ckemere/LaserDriver/LaserHAT/LaserDriver.kicad_pcb

## KiCad design LaserHAT/LaserDriver.kicad_pcb (2026-05-15)

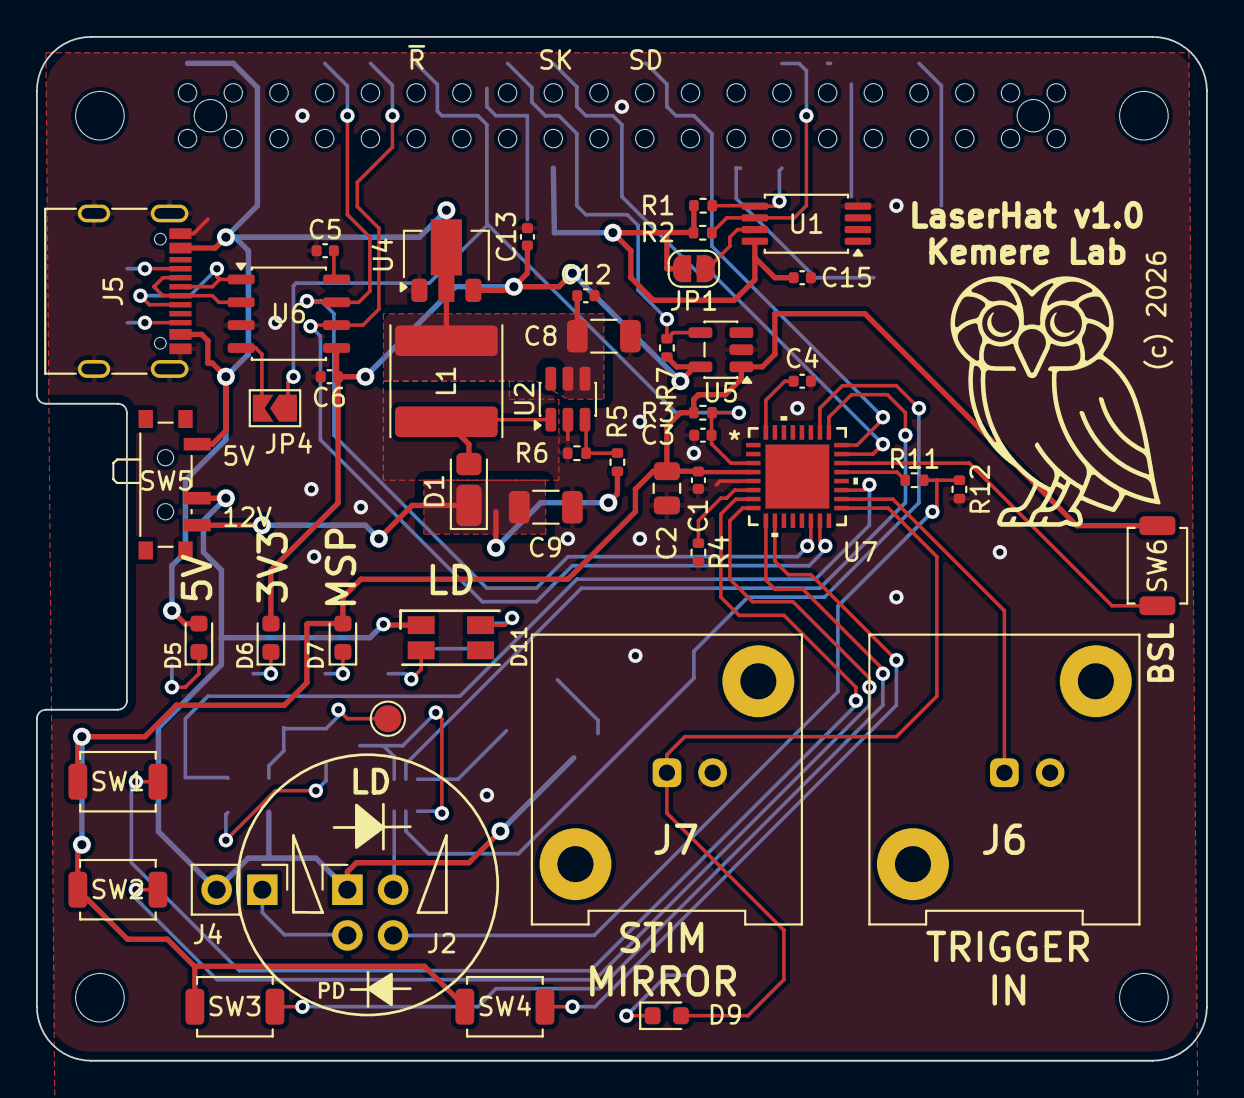
[picture p1: board LaserDriver.kicad_pcb from above]

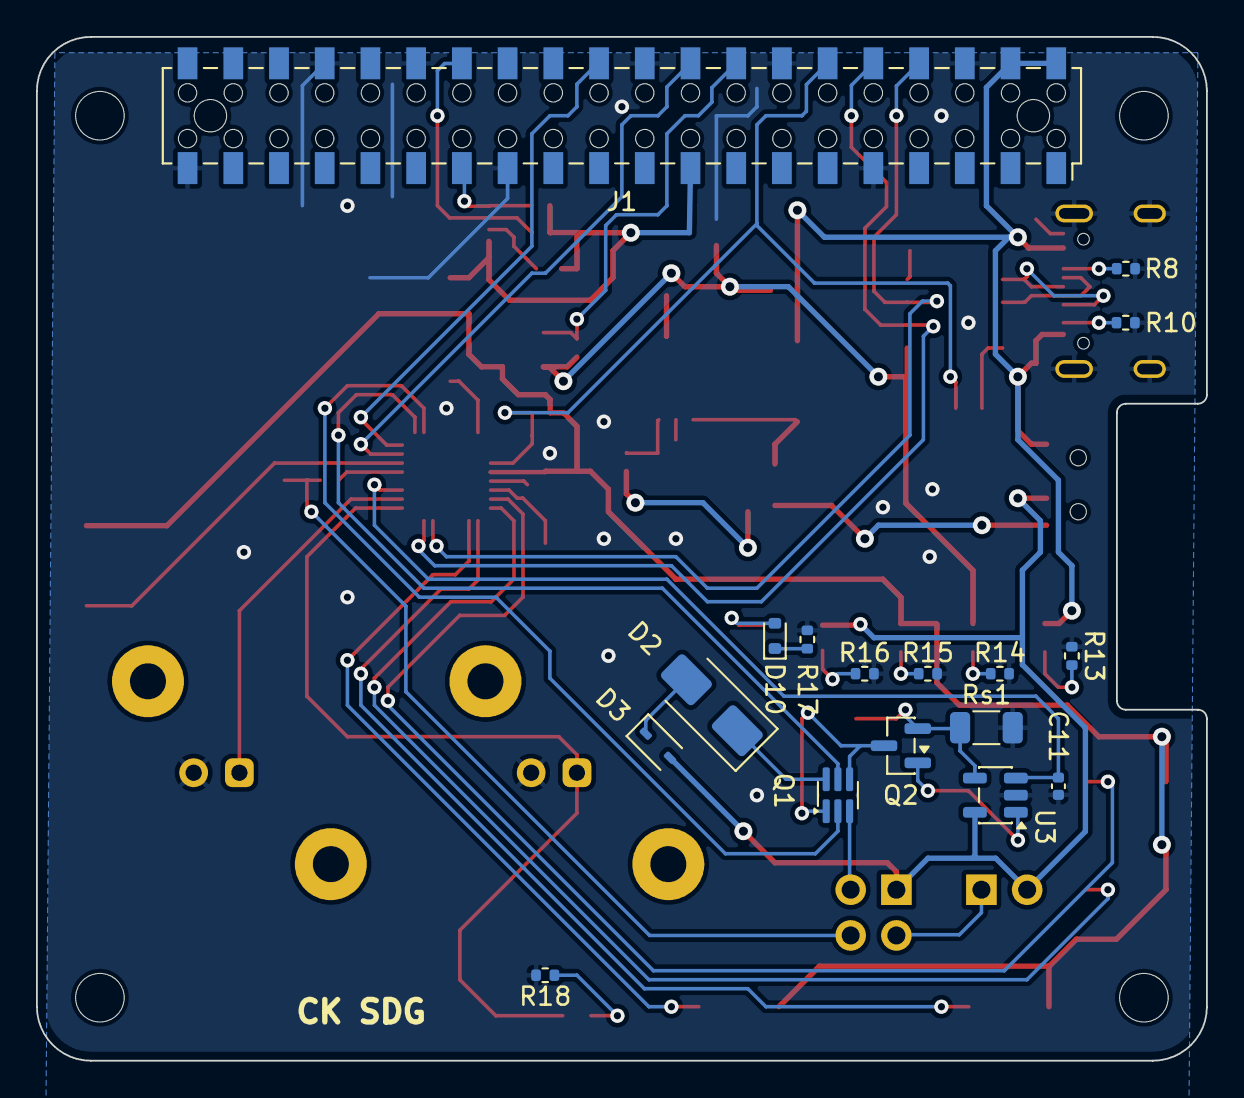
[picture p2: board LaserDriver.kicad_pcb from below]

Board: 2 copper layers, 65.0 x 56.9 mm, 68 parts (17 on the bottom side), 52 nets.

Parts:
C1, C5, C6, C12, C15: 100nF; C_0402_1005Metric
C2: 10uF; C_0805_2012Metric
C3, C11: 10nF; C_0402_1005Metric
C4: 0.47uF; C_0402_1005Metric
C8, C9: 22µF 16V; C_1206_3216Metric
C13: 1uF Ceramic; C_0402_1005Metric
D1: SS14; D_SOD-123F
D2: Zener 4.7V, 1.5W; D_SMA
D3: 1N4148W; D_SOD-323F
D5: 5V; D_0603_1608Metric
D6: 3v3; D_0603_1608Metric
D7: MSPM0; D_0603_1608Metric
D9: STIM; D_0603_1608Metric
D10: D_Zener 6.2V; D_SOD-523
D11: LED_ABGR; LED_RGB_1210
J1: GPIO; Samtec_HLE-120-02-xxx-DV-BE-LC_2x20_P2.54mm_Horizontal
J2: Conn_02x02_Counter_Clockwise; PinHeader_2x02_P2.54mm_Vertical
J4: Jumper for 4-terminal diode configuration; PinHeader_1x02_P2.54mm_Vertical
J5: USB_C_Receptacle_USB2.0_16P; USB_C_Receptacle_G-Switch_GT-USB-7010ASV
J6, J7: Conn_Coaxial; BNC_Amphenol_031-5539_Vertical
JP1: ID_WP; SolderJumper-2_P1.3mm_Open_RoundedPad1.0x1.5mm
JP4: ID_WP; SolderJumper-2_P1.3mm_Open_TrianglePad1.0x1.5mm
L1: 22uH; L_APV_ANR6045
MH1, MH2, MH3, MH4: MountingHole_2.7mm_M2.5
Q1: SI3134KDWA-TP; SOT-363_SC-70-6
Q2: DMN2056U; SOT-23
R1, R2: 3.9k; R_0402_1005Metric
R3: 47k 1%; R_0402_1005Metric
R4: 100k 0.1%; R_0402_1005Metric
R5: 187k 1%; R_0402_1005Metric
R6, R7: 10k; R_0402_1005Metric
R8, R10: 5.1k; R_0402_1005Metric
R11: 1k 0.1%; R_0402_1005Metric
R12: 4.7k; R_0402_1005Metric
R13, R17: 1k 1%; R_0402_1005Metric
R14, R15: 200; R_0402_1005Metric
R16, R18: 470; R_0402_1005Metric
Rs1: 10Ω 1%; R_1206_3216Metric
SW1, SW2, SW3, SW4: B; SW_SPST_TS-1088-xR020
SW5: SW_SPDT; SW_SPDT_PCM12
SW6: BSL; SW_SPST_TS-1088-xR020
TP1: TestPoint; TestPoint_Pad_D1.5mm
U1: CAT24C32; TSSOP-8_4.4x3mm_P0.65mm
U2: MT3608; SOT-23-6
U3: TLV2371DBV; SOT-23-5
U4: MCP1700x-330xxMB; SOT-89-3
U5: AP2171W; SOT-23-5
U6: CH340N; JEITA_SOIC-8_3.9x4.9mm_P1.27mm
U7: MSPM0G3507SRHBR; VQFN32_RHB_TEX

Connections:
+3V3: C6.1, C13.1, D6.2 (A), R7.1, U4.3 (VO), U5.5 (IN), U6.5 (VCC)
+5V: C8.1, C12.1, D5.2 (A), J1.2, J1.4, J5.A4 (VBUS), J5.A9 (VBUS), J5.B4 (VBUS), J5.B9 (VBUS), L1.1, SW5.1 (A), U2.4 (EN), U2.5 (IN), U4.2 (VI)
+12V: C9.1, D1.1 (K), R5.1, SW5.3 (C)
/GPIO14/TXD0: J1.8, U6.7 (RXD), U7.14 (PA10/CLK_OUT)
/GPIO15/RXD0: J1.10, U6.6 (TXD), U7.15 (PA11)
/GPIO18/PCM.CLK: C3.1, J1.12, JP4.1 (A), R3.2, U7.3 (NRST)
/GPIO23: J1.16, R7.2, U5.4 (EN)
/GPIO24: J1.18, U7.23 (PA19/SWDIO)
/GPIO25: J1.22, U7.24 (PA20/SWCLK)
/ID_SCL: J1.28, R2.2, U1.6 (SCL)
/ID_SDA: J1.27, R1.2, U1.5 (SDA)
/Laser Driver Circuit/DIODE_ADC: R11.1, U7.21 (PA17/A1_2)
/Laser Driver Circuit/IDrive: Q2.2 (S), Rs1.1, TP1.1, U3.4 (-)
/Laser Driver Circuit/LASER_VREF: C11.1, U3.3 (+), U7.19 (PA15/A1_0/DAC_OUT)
/Laser Driver Circuit/LaserDrive: Q1.1 (S), Q1.4 (S), Q2.3 (D)
/Laser Driver Circuit/PWM_DUMMY: Q1.2 (G), U7.26 (PA22/CLK_OUT/A0_7)
/Laser Driver Circuit/PWM_LASER: Q1.5 (G), U7.25 (PA21/A1_7/VREF-)
/Laser Driver Circuit/SW: D1.2 (A), L1.2, U2.1 (SW)
/MSPM0 Controller/BUTTON1: SW1.1, U7.7 (PA3/COMP1_OUT/LFXIN)
/MSPM0 Controller/BUTTON2: SW2.1, U7.8 (PA4/LFCLK_IN/LFXOUT)
/MSPM0 Controller/BUTTON3: SW3.1, U7.9 (PA5/HFXIN/FCC_IN)
/MSPM0 Controller/BUTTON4: SW4.1, U7.10 (PA6/HFCLK_IN/HFXOUT)
/MSPM0 Controller/MSPM0_BSL_INVOKE: SW6.1, U7.22 (PA18/A1_3)
/STIM_MIRROR: D9.2 (A), J7.1 (In), U7.17 (PA13)
/STIM_TRIGGER: J6.1 (In), U7.18 (PA14/CLK_OUT/A0_12)
/USB-C UART/CH340_RTS: JP4.2 (B), U6.4 (~RTS)
GND: C1.2, C2.2, C3.2, C4.2, C5.1, C6.2, C8.2, C9.2, C11.2, C12.2, C13.2, C15.2, J1.6, J1.9, J1.14, J1.20, J1.25, J1.30, J1.34, J1.39, J5.A1 (GND), J5.A12 (GND), J5.B1 (GND), J5.B12 (GND), J5.S1 (SHIELD), J6.2 (Ext), J7.2 (Ext), R4.2, R6.2, R8.2, R10.2, R12.2, R13.2, R14.2, R15.2, R16.2, R17.2, R18.2, Rs1.2, U1.4 (GND), U2.2 (GND), U3.2 (V-), U4.1 (GND), U5.2 (GND), U6.3 (GND), U7.5 (VSS)
LASER_V: D3.2 (A), D11.1 (A), J2.1 (LD_Anode), J4.2, SW5.2 (B), U3.5 (V+)
MSPM0_3V3: C1.1, C2.1, D7.2 (A), R3.1, SW1.2, SW2.2, SW3.2, SW4.2, SW6.2, U5.1 (OUT), U7.4 (VDD)
unnamed: D2.2 (A), D3.1 (K)
unnamed: D2.1 (K), Q1.6 (D)
unnamed: D5.1 (K), R13.1
unnamed: D6.1 (K), R14.1
unnamed: D7.1 (K), R15.1
unnamed: D9.1 (K), R18.1
unnamed: D10.2 (A), D11.4 (RK)
unnamed: D10.1 (K), R17.1
unnamed: D11.2 (BK), R16.1
unnamed: J2.2 (LD_Cathode), Q1.3 (D)
unnamed: J2.4 (PD_Anode), R11.2, R12.1
unnamed: J2.3 (PD_Cathode), J4.1
unnamed: J5.A5 (CC1), R8.1
unnamed: J5.B5 (CC2), R10.1
unnamed: JP1.1 (A), U1.7 (WP)
unnamed: Q2.1 (G), U3.1
unnamed: R5.2, R6.1, U2.3 (FB)
unnamed: J5.A6 (D+), J5.B6 (D+), U6.1 (UD+)
unnamed: J5.A7 (D-), J5.B7 (D-), U6.2 (UD-)
unnamed: C5.2, U6.8 (V3)
ROSC: R4.1, U7.6 (PA2/ROSC)
RPi +3V3: C15.1, J1.1, J1.17, JP1.2 (B), R1.1, R2.1, U1.8 (VCC)
VCORE: C4.1, U7.32 (VCORE)
