ckemere/LaserDriver/PCB/laser_driver.kicad_pcb

## KiCad design PCB/laser_driver.kicad_pcb (2026-04-27)

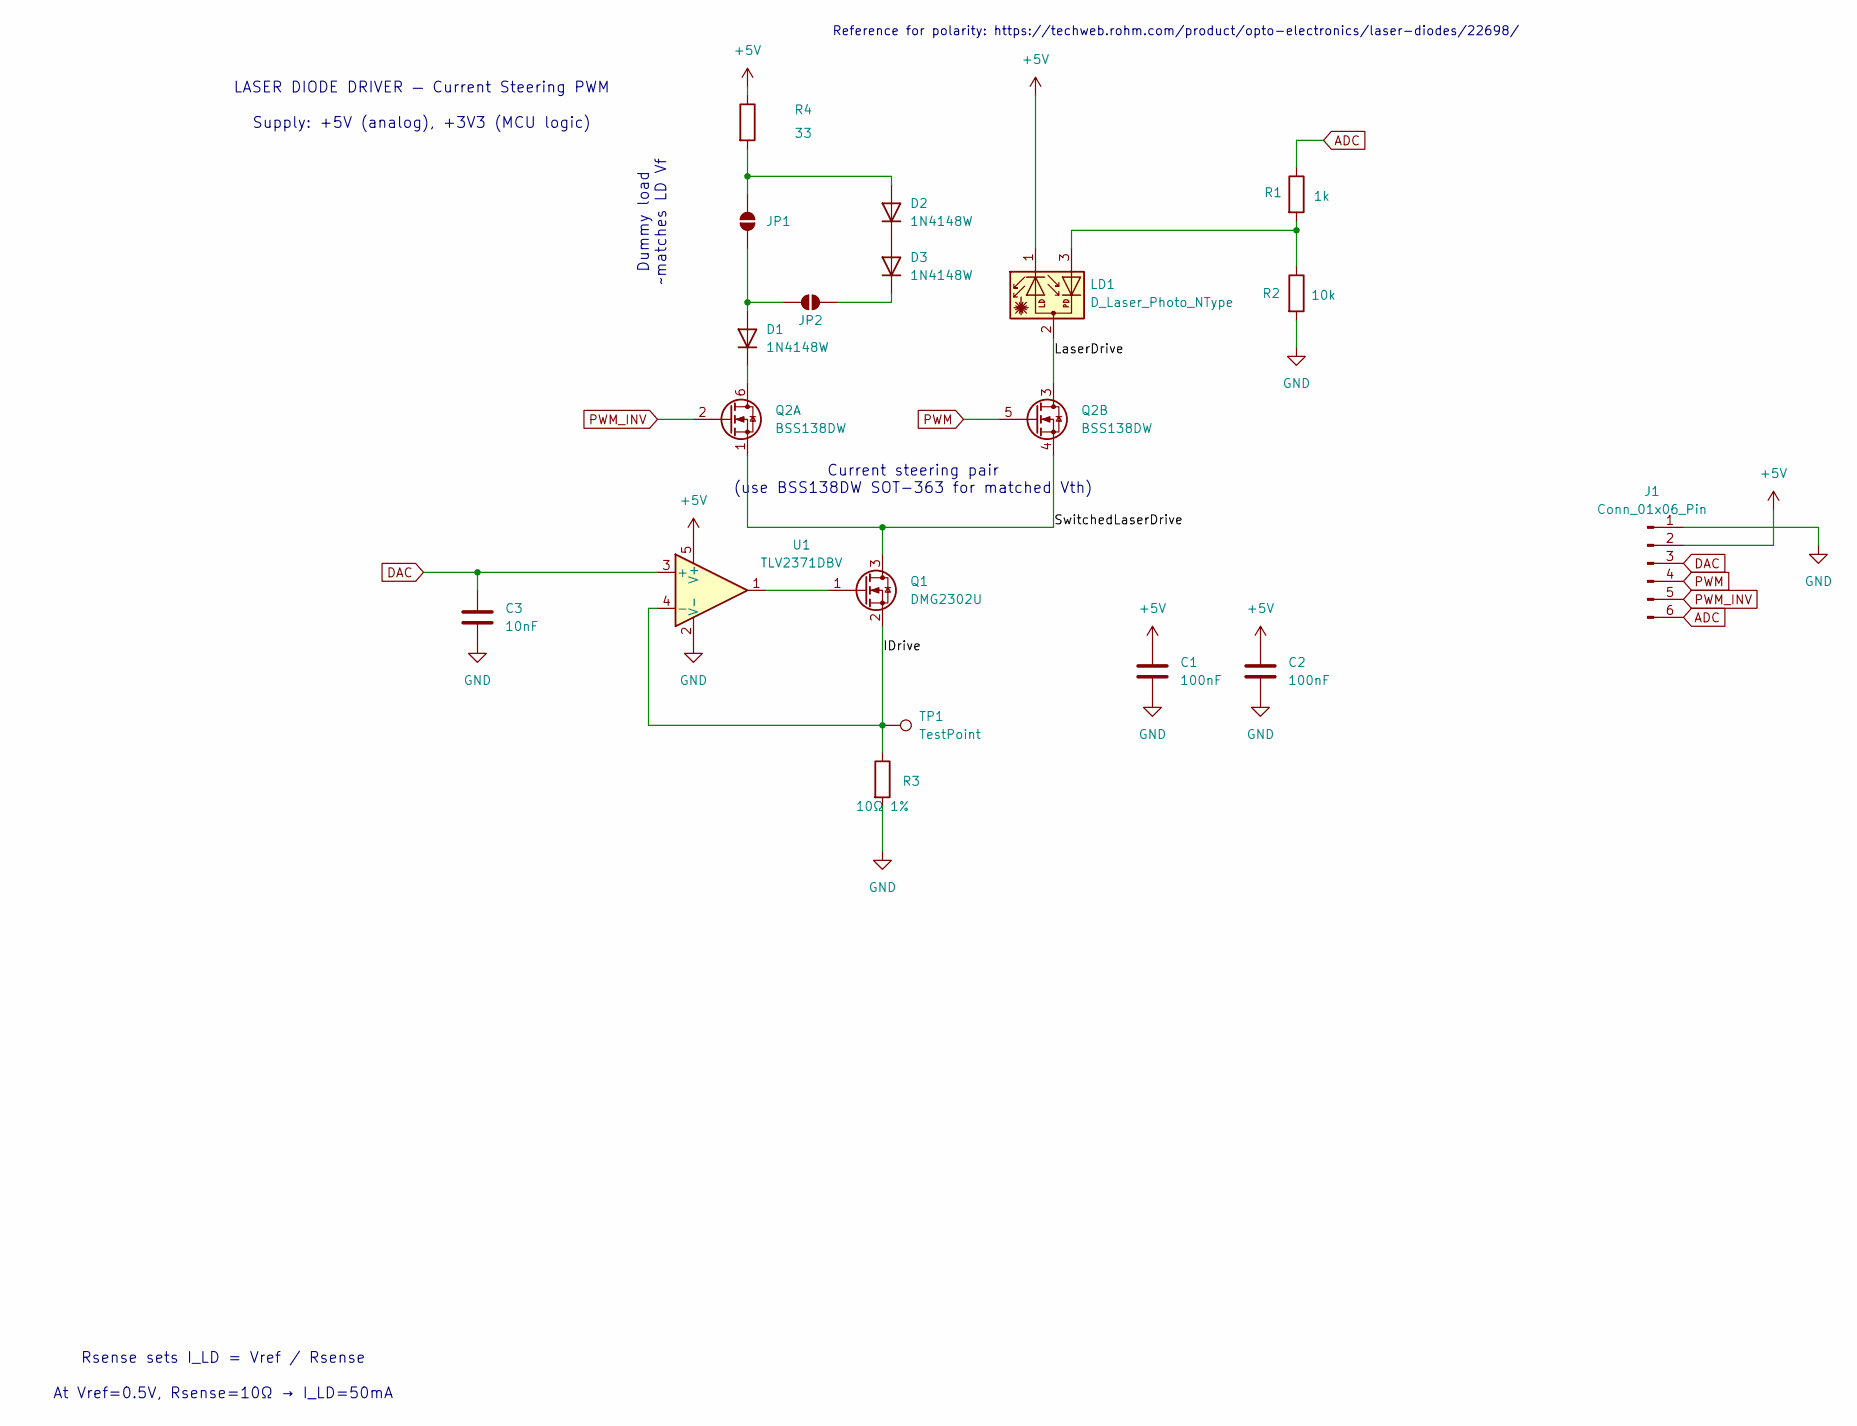
[picture p4: schematic laser_driver.kicad_sch, Laser Diode Driver with Current Steering PWM]

Parts:
C1, C2: 100nF; C_0402_1005Metric
C3: 10nF; C_0402_1005Metric
D1, D2, D3: 1N4148W; D_SOD-123
J1: Conn_01x06_Pin; PinHeader_1x06_P2.54mm_Vertical
JP1, JP2: SolderJumper-2_P1.3mm_Open_TrianglePad1.0x1.5mm
LD1: D_Laser_Photo_NType; PinHeader_1x03_P2.54mm_Vertical
Q1: DMG2302U; SOT-23
Q2: BSS138DW; SOT-363_SC-70-6
R1: 1k; R_0402_1005Metric
R2: 10k; R_0402_1005Metric
R3: 10Ω 1%; R_0402_1005Metric
R4: 33; R_0402_1005Metric
TP1: TestPoint; PinHeader_1x01_P2.54mm_Vertical
U1: TLV2371DBV; SOT-23-5

Connections:
+5V: C1.1, C2.1, J1.2, LD1.1, R4.1, U1.5 (V+)
/IDrive: Q1.2 (S), R3.1, TP1.1, U1.4 (-)
/LaserDrive: LD1.2, Q2.3 (D)
/SwitchedLaserDrive: Q1.3 (D), Q2.1 (S), Q2.4 (S)
ADC: J1.6, R1.1
DAC: C3.1, J1.3, U1.3 (+)
GND: C1.2, C2.2, C3.2, J1.1, R2.2, R3.2, U1.2 (V-)
unnamed: D1.2 (A), JP1.2 (B), JP2.2 (B)
unnamed: D1.1 (K), Q2.6 (D)
unnamed: D2.2 (A), JP1.1 (A), R4.2
unnamed: D2.1 (K), D3.2 (A)
unnamed: D3.1 (K), JP2.1 (A)
unnamed: LD1.3, R1.2, R2.1
unnamed: Q1.1 (G), U1.1
PWM: J1.4, Q2.5 (G)
PWM_INV: J1.5, Q2.2 (G)

Notes on the sheet:
Supply: +5V (analog), +3V3 (MCU logic)
Current steering pair (use BSS138DW SOT-363 for matched Vth)
Dummy load ~matches LD Vf
Rsense sets I_LD = Vref / Rsense
LASER DIODE DRIVER — Current Steering PWM
Reference for polarity: https://techweb.rohm.com/product/opto-electronics/laser-diodes/22698/
At Vref=0.5V, Rsense=10Ω → I_LD=50mA

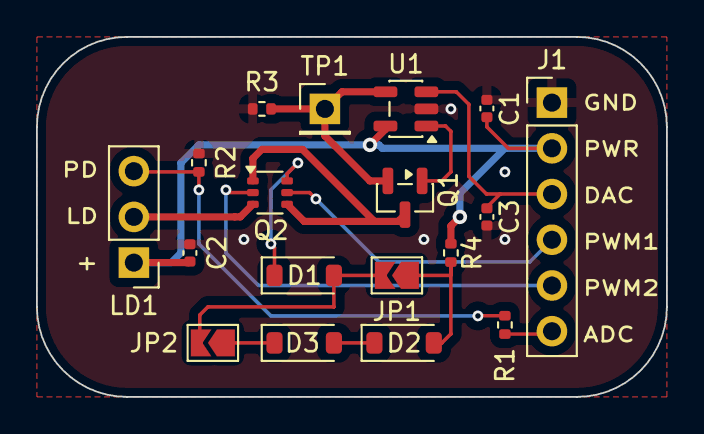
[picture p5: board laser_driver.kicad_pcb from above]

Board: 2 copper layers, 35.0 x 20.0 mm, 18 parts (0 on the bottom side), 16 nets.
