ckemere/LaserDriver/(commit log)

2026-04-27 Initial Commit of PCB
    [laser_driver.kicad_pcb, laser_driver.kicad_sch]
2026-04-27 Add complementary PWM modulation to laser driver firmware
    Adds a TIMA0-based complementary PWM output pair on PA12/PA13 (J4
    header pins) to drive the H-bridge gates Q2a/Q2b in the current
    steering topology described in PCB/DESIGN_NOTES.md.
    Configuration:
    - TIMA0, CC0 channel with native CCP0/CCP0N complementary outputs
    - Clock: BUSCLK = 32 MHz, prescale = 1
    - Period: 3200 counts → 100 µs (10 kHz)
    - Duty cycle: ccValue = 1600 → 50% initially
    - No deadband: both outputs flip on the same compare event, ensuring
    the current source Q1 always has a path to ground through Q2a or Q2b
    - Shadow load enabled for clean duty-cycle updates at timer zero event
    laser_driver.c: start PWM counter aft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
    [laser_driver.c]
2026-04-27 Add PA0 GPIO blink at ~1 Hz after laser diode enable
    Configures PA0 as a push-pull output via SysConfig (GPIO_BLINK group)
    and replaces the WFI idle loop with a busy-wait toggle loop that fires
    every 500 ms (~1 Hz) using the 32 MHz default MCLK.
    [laser_driver.c]
2026-04-27 Add complementary PWM modulation at 10% laser duty cycle
    Configure TIMA0 in edge-aligned PWM mode at 10 kHz using the native
    CCP0/CCP0N complementary pair (PA8/PA22, no deadband generator) to
    steer current between the laser path (Q2a) and dummy path (Q2b).
    Both outputs flip on the same compare event giving zero guard band.
    10% duty cycle: ccValue=2880 of 3200 counts, laser ON 10% of period.
    [laser_driver.c]
2026-04-28 Ensure safe boot: DAC zero, dummy branch always on, laser branch off
    Set DAC12 output voltage to 0 V so the current setpoint is zero on
    startup. Set PWM ccValue to 3199 (= timerCount) so CCP0 (dummy path)
    is HIGH for ~100% of each cycle and CCP0N (laser path) is HIGH for
    only ~31 ns per 100 µs period; with DAC = 0 V the laser diode is
    never driven even during that brief window.
2026-04-28 Add trapezoidal laser pulse ramp at 100 kHz PWM
    Raises PWM frequency from 10 kHz to 100 kHz (period=320 counts at 32 MHz
    BUSCLK) giving 320-step duty-cycle resolution.
    Implements a repeating trapezoidal intensity profile driven by the TIMA0
    zero-event ISR:
    - Rise: 0 % -> 100 % over 2 s (625 ticks/step × 320 steps)
    - Hold high: 100 % for 1 s
    - Fall: 100 % -> 0 % over 2 s
    - Hold low: 0 % for 1 s
    DAC setpoint is fixed at 100 (≈ 61 mV on the 2.5 V reference) and set
    once at boot before pulses start. A pulse_active flag gates the state
    machine; currently auto-set in main so the ramp begins at power-on.
    Setting it from a button ISR instead will be straightforward to add.
    Co-Authored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
    [laser_driver.c]
2026-04-28 Fix flash at end of ramp-down; drive output unconditionally in every state
    Root cause: STATE_HOLD_HIGH never called set_laser_step, leaving the PWM
    shadow register with ccValue=0 (laser 100%) from the last RAMP_UP tick.
    That stale value persisted into the first ~625 ticks of STATE_RAMP_DOWN,
    producing a bright flash before the first ramp step could override it.
    Fix: move set_laser_step to the bottom of every state case, after updating
    ramp_step, so the shadow register is always driven to the correct value on
    every tick regardless of whether a threshold fired or a transition occurred.
    Also removes the now-redundant ramp_step=RAMP_STEPS assignment in HOLD_HIGH
    since HOLD_HIGH drives set_laser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
    [laser_driver.c]
2026-04-28 Implement safe laser-off via IOMUX switching between GPIO and PWM
    Bridge pins PA8/PA22 now boot as GPIO (dummy HIGH, laser LOW) via
    SysConfig GPIO instances. laser_pwm_control.c switches them to
    TIMA0_CCP0/CCP0_CMPL at runtime when PWM is active, and back to
    GPIO-safe-state when the laser should be off — eliminating the
    ccValue=320 ambiguity that could produce full laser power.
2026-04-28 Remove PWM from SysConfig; configure TIMA0 entirely in software
    SysConfig PWM module was defaulting to PA0 as its CCP0 output pin,
    modulating an unrelated LED. Remove the PWM module from syscfg so
    SysConfig never touches TIMA0 pins. Add laser_pwm_init() which
    replicates the same timer configuration (BUSCLK/1, 100 kHz
    edge-aligned PWM, CC0 shadow-on-zero) using driverlib calls directly.
    Update laser_driver.c to call laser_pwm_init() and reference TIMA0
    and TIMA0_INT_IRQn directly instead of the now-gone generated macros.
2026-04-29 Switch to UP-mode PWM, fix pin naming, separate tick timer
    Three changes:
    - Pin naming: PA8 is the laser branch (CCP0 direct), PA22 is the
    dummy branch (CCP0_CMPL). Rename SysConfig GPIO instances and all
    code references accordingly.
    - UP-mode PWM: switch TIMA0 to DL_TIMER_PWM_MODE_EDGE_ALIGN_UP with
    INIT_VAL_HIGH so CC0 value maps directly to laser duty
    (0 = off, 320 = 100%). Removes the inverted subtraction from
    set_laser_step().
    - Separate tick timer: TIMG0 generates the 100 kHz state-machine
    tick interrupt; TIMA0 runs pure PWM with no interrupt, making the
    role of each timer unambiguous.
    [laser_driver.c, laser_pwm_control.c]
2026-04-29 Fixed Claude errors, including correcting laser off GPIO settings and fixing initial GPIO state. Updated instructions.
    [laser_driver.c, laser_pwm_control.c]
2026-04-29 Refactor state machine into get_next_state/set_output functions
    State is now a LaserState struct (phase + ramp_step + tick_count) so
    both transition logic and hardware output are fully determined by the
    struct alone. Main loop reduces to three lines. Document the philosophy
    in CLAUDE.md.
2026-04-29 Add button trigger on PB21 with debounced release detection
    PB21 is configured as active-low input with internal pull-up via SysConfig.
    The state machine grows a ButtonPhase sub-state and an OverallPhase that
    separates WAITING_FOR_TRIGGER from TRIGGERED. Pressing then releasing the
    button fires one trapezoidal laser cycle; further presses are ignored until
    the cycle completes. Button is polled at 100 kHz; 10 ms debounce applied
    to both press and release edges.
2026-04-30 Add Raspberry Pi HAT laser driver KiCad project (LaserHAT/)
    Four-sheet hierarchical schematic based on the Rpi-pcb template UUID:
    - Root sheet: Pi 2×20 GPIO connector, DMG2305UX P-MOSFET MSPM0 power
    switch (Pi GPIO17), BNC trigger input, 5-pin SWD header, AT24C256C
    HAT EEPROM with 4.7k I2C pull-ups
    - Sheet 2 (laser_driver_circuit): MT3608 boost converter (5V→12V,
    R_FB1=187k/R_FB2=10k → 11.82V), full TLV2371/Si1902DL/Q1 current-
    steering driver with fail-safe gate pull resistors
    - Sheet 3 (mspm0_controller): MSPM0G3507RGZR QFN-64 with decoupling;
    PA8=PWM_LASER, PA22=PWM_DUMMY, PA12=DAC/VREF, PB21=TRIGGER
    - Sheet 4 (usb_uart): CH340N USB-C UART bridge with SB1/SB2 solder
    bridg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
    [LaserDriver.kicad_pcb, LaserDriver.kicad_sch, laser_driver_circuit.kicad_sch, mspm0_controller.kicad_sch, usb_uart.kicad_sch]
2026-04-30 Regenerate schematics via kiutils; add generate_schematics.py
    Previous hand-written schematics failed to open in eeschema due to
    quoted UUIDs and unrecognised generator_version field. Replace with
    a kiutils-based Python generator that produces correctly-formatted
    KiCad 9 S-expressions.
    Each sheet now has:
    - Unquoted UUIDs and proper PageSettings object (eeschema-compatible)
    - HierarchicalLabel port declarations matching parent sheet pins
    - LocalLabel net labels placed at exact pin connection points so KiCad
    can build the netlist without manual wire routing
    - NoConnect markers on unused pins (SBU1/SBU2, DTR, MT3608 NC pin)
    - SymbolInstance entries for BOM/netlist annotation
    Add requireme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
    [LaserDriver.kicad_sch, laser_driver_circuit.kicad_sch, mspm0_controller.kicad_sch, usb_uart.kicad_sch]
2026-04-30 Fix pin orientation error: set angle=0 on lib symbol pins with angle=None
    KiCad eeschema requires a numeric angle in every pin (at X Y angle) clause.
    Lib symbols copied from the original hand-written schematics had angle=None
    on connector pins, which kiutils serialised as (at X Y) — two numbers
    instead of three — causing the 'need a number for pin orientation' parse
    error.
    Add _fix_lib_sym_angles() called from copy_lib_syms() to default any
    None angle to 0 before the symbol is added to the output schematic.
    [LaserDriver.kicad_sch, laser_driver_circuit.kicad_sch, mspm0_controller.kicad_sch, usb_uart.kicad_sch]
2026-04-30 Implement schematic design rules; add CLAUDE.md
    - Rule 1: hide pin names/numbers on passive parts (R, C, L)
    - Rule 2: add ≥5mm wire stub before every net label
    - Rule 3: preserve hand-edited laser_driver.kicad_sch by loading from PCB/ original
    - Rule 4: generous component spacing across multiple sheets
    - Add CLAUDE.md documenting all rules, setup, signal naming, and kiutils conventions
    [LaserDriver.kicad_sch, laser_driver_circuit.kicad_sch, mspm0_controller.kicad_sch, usb_uart.kicad_sch]
2026-04-30 Fix three schematic generation bugs
    - Symbol unit names: set entryName on manually-created Symbol units so
    they serialize as "+LASER_V_0_1" not "None_0_1" (KiCad load error)
    - Passive pin hiding: set pinNames=True alongside pinNamesHide=True so
    the (pin_names hide) token is actually emitted for Device:C and Device:L
    - Property visibility: hide Footprint/Datasheet/Description on all
    schematic symbol instances; only Reference and Value remain shown
    [LaserDriver.kicad_sch, laser_driver_circuit.kicad_sch, mspm0_controller.kicad_sch, usb_uart.kicad_sch]
2026-04-30 Fix PCB file: remove semicolon comments, drop invalid pintype tokens
    KiCad S-expression parser does not support any comment syntax.
    Semicolon comments on lines 93+ caused the 'Expecting (' parse error.
    Also removed (pintype "passive") from pad entries — that token belongs
    in schematics, not PCB files.
    [LaserDriver.kicad_pcb]
2026-04-30 Document PCB file rules in CLAUDE.md
2026-05-01 Add RPi 40-pin GPIO header to root schematic with full pin connections
    - place_pi_header() places Conn_02x20_Odd_Even at (40, 230) with:
    - Pins 1,17: +3V3 power symbols
    - Pins 2,4: VCC_5V_IN net labels (boost converter input)
    - Pins 6,9,14,20,25,30,34,39: GND power symbols
    - Pin 8/10: UART_TX/UART_RX (GPIO14/15)
    - Pin 11: Pi_GPIO17 (MCU power enable → R_GATE)
    - Pins 27/28: ID_SDA/ID_SCL (HAT EEPROM, per HAT spec)
    - Pin 37: TRIGGER (GPIO26 → BNC/MSPM0)
    - All other pins: no-connect markers
    - Fix TRIGGER_SIG → TRIGGER to match MSPM0 sub-sheet port name
    - Fix power:3V3 → power:+3V3 bug (lstrip("+") was wrong)
    [LaserDriver.kicad_sch, mspm0_controller.kicad_sch]
2026-05-01 Preserve GPIO header UUID by loading from original schematic
    The PCB footprint for J1 (40-pin GPIO header) has
    (path "/212bfd25-0010-0000-0000-000000000001")
    which must match the schematic symbol UUID. Regenerating the symbol
    with a random UUID silently orphans the footprint.
    Fix: build_root() now loads PCB/laserhat_root_orig.kicad_sch (extracted
    from the initial commit) and borrows the pristine Conn_02x20_Odd_Even
    lib symbol + J1 instance verbatim. Only net labels/power symbols/
    no-connects are added; the symbol itself (UUID, pin UUIDs, position,
    lib symbol definition) is untouched.
    Also add hide_extra_properties() call at end of build_root() and
    document the UUID invariant in CLAUDE.md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
    [LaserDriver.kicad_sch, laserhat_root_orig.kicad_sch]
2026-05-01 Added hat template files to this branch
    [PiHatTemplate.kicad_pcb, PiHatTemplate.kicad_sch]
2026-05-02 Rebase schematic and PCB from PiHatTemplate
    Schematic (LaserDriver.kicad_sch): template taken as base verbatim,
    preserving all GPIO connector symbols, pin labels, decoupling caps,
    ID EEPROM notes, and solder jumpers exactly as drawn. Paper changed
    A4→A3; title block updated. Three sub-sheet boxes (Laser Driver,
    MSPM0, USB-C UART) appended at x=230 to avoid overlap with the
    template's GPIO content.
    PCB (LaserDriver.kicad_pcb): replaced with PiHatTemplate PCB, which
    uses the correct PinSocket_2x20 on B.Cu (female, mates with Pi header)
    and includes proper board-outline notches, stackup, and mounting holes.
    Updated sheetfile reference to LaserDriver.kicad_sch; J1 UUID link
    (00000000-0000-000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
    [LaserDriver.kicad_pcb, LaserDriver.kicad_sch]
2026-05-02 Fix floating hierarchical_labels in child schematics
    Every hierarchical_label must be at the end of a connected wire stub.
    The generated schematics had hlabels placed at sheet-edge coordinates
    (5,20-80) and (200,20-50) with no wires, while using local labels at
    the actual pin stubs.
    fix_labels.py:
    - Removes floating hlabels from mspm0_controller and usb_uart sheets
    - Replaces each signal's local label with a hierarchical_label at the
    same wire-stub position (9 signals in MSPM0, 4 in USB-UART)
    - Adds VCC_3V3_MCU/GND hlabels in MSPM0 via short wire stubs branching
    off the existing VDD/VSS power symbol connection points
    Also commits generate_schematics.py verbatim-injection patch and mino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
    [laser_driver_circuit.kicad_sch, mspm0_controller.kicad_sch, usb_uart.kicad_sch]
2026-05-04 Add LaserHAT README with design overview and key subsystem docs
    Covers: design philosophy (Pi for timing, MCU for precision), power
    system (MT3608 boost, P-MOSFET MCU power switch), laser driver
    (current-steering PWM topology, BSS138DW pair, TLV2371 feedback),
    USB/UART dual-mode interface (SB1/SB2 solder bridges), MSPM0 pin
    assignments, and SWD debug header pinout.
2026-05-06 Updates with lots of manual work
    [LaserDriver.kicad_sch, eink.kicad_sch, laser_driver_circuit.kicad_sch, mspm0_controller.kicad_sch, usb_uart.kicad_sch]
2026-05-09 Updates to design, finalized PCB layout
    [LaserDriver.kicad_pcb, LaserDriver.kicad_sch, laser_driver_circuit.kicad_sch, mspm0_controller.kicad_sch, usb_uart.kicad_sch]
2026-05-15 Updated project for manufacturing. Should merge branch if/when we get back a working product
    [LaserDriver.kicad_pcb, LaserDriver.kicad_sch, laser_driver_circuit.kicad_sch, mspm0_controller.kicad_sch, usb_uart.kicad_sch]
2026-06-02 Added laserHat firmware rev 0.1
2026-06-03 Fix PWM laser drive to use PA21 (TIMA0_CCP0 on PINCM46)
    U7 (VQFN-32) wires PWM_LASER to PA21, not PA8. PA21 supports
    TIMA0_CCP0 via PINCM46 PF=5, so the fix is just swapping the IOMUX
    function constants in laser_pwm_control.c. Timer setup, CCP0 indices,
    and the PA22 dummy path are unchanged.
    Also: restore the bypassed RAMP_DOWN transition, fix the DAC setpoint
    comment, and call laser_pins_to_gpio_safe() explicitly at boot.
    Add LaserHAT/gpio_design.md documenting the validated Pi-and-MCU GPIO
    map for U7 along with remaining firmware/HW gaps.
    [laser_driver.c, laser_pwm_control.c, laser_pwm_control.h]
2026-06-03 Add boot blink; fix button polarity to active-high with PULL_DOWN
    Buttons are wired to +3V3 on press (verified on schematic: SW1 pin 2 ->
    MSPM0_3V3), so the prior PULL_UP + active-low read would never see a
    press. Switch syscfg to PULL_DOWN and flip the polarity check in
    get_next_state().
    Replace the TIMER_0/TIMG7 heartbeat blink (which fought set_output()
    for the STIM_MIRROR LED on PA13) with a self-contained OVERALL_BOOT
    phase: ~4 s of 5 Hz blink on PA13 at power-on, then transition to
    OVERALL_WAITING. During pulses STIM_MIRROR follows the laser-on state.
    Drop the TIMER_0 module from syscfg and its IRQ handler.
    Document the button wiring and pull-down requirement in
    LaserHAT/gpio_design.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
    [laser_driver.c]
2026-06-03 Add board.h + register-level SYSCTL and GPIO modules
    First step toward dropping the SysConfig / driverlib dependency so the
    firmware can be built with stock arm-none-eabi-gcc on the Pi.
    - board.h centralizes pin assignments (PA21 PWM_LASER, PA22 PWM_DUMMY,
    PA3 BUTTON1, PA13 STIM_MIRROR, PA15 DAC, PA10/PA11 UART, PA23 VREF+)
    so peripheral modules don't need SysConfig-generated names.
    - laser_sysctl.c/h replaces SYSCFG_DL_SYSCTL_init: BOR level 0, SYSOSC
    base 32 MHz, MFPCLK on sourced from SYSOSC.
    - laser_gpio.c/h replaces SYSCFG_DL_GPIO_init: unused-pin defaults,
    PA21/PA22 digital outputs, PA3 input with PULL_DOWN, PA13 LED output.
    Inline hot-path read/set/clear helpers for button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
    [board.h, laser_driver.c, laser_gpio.c, laser_gpio.h, laser_sysctl.c, laser_sysctl.h]
2026-06-03 Add register-level laser_timera (TIMA0 PWM) module
    laser_timera_init() replaces what laser_pwm_init() does through
    driverlib: TIMA0 reset + power-enable, BUSCLK source /1, period 320,
    edge-aligned up-counting four-CC PWM, CC0 INIT_VAL_HIGH, CCUPD at
    zero-event, CC0 output declared. Constants come straight from the
    device header (GPTIMER_* aliases that DL_TIMER_* resolved to).
    Inline laser_timera_set_duty() writes CC_01[0] directly for the
    state-machine hot path.
    Runs in parallel with the existing laser_pwm_init(); the latter still
    writes the same registers a moment later, so behavior is unchanged on
    the bench. Will collapse once the SysConfig-driven path is dropped.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
    [laser_driver.c, laser_timera.c, laser_timera.h]
2026-06-03 Add register-level laser_timerg (TIMG0 100 kHz tick) module
    laser_timerg_init() configures TIMG0 as periodic DOWN-counting timer
    at 100 kHz with the zero-event interrupt unmasked at the peripheral.
    Same register sequence the existing tick_timer_init() drives through
    driverlib, just spelled out with GPTIMER_* device-header constants.
    Inline laser_timerg_ack() reads CPU_INT.IIDX from the IRQ handler.
2026-06-03 Add register-level laser_dac (DAC0 + internal VREF) module
    laser_dac_init() brings up VREF first (buffered 2.5 V output sourced
    from LFCLK) then DAC0 (12-bit binary, VEREFP/VEREFN source, output
    amplifier on, FIFO + sample timer disabled). laser_dac_write12() is
    an inline DATA0 write; laser_dac_enable() flips the CTL0 enable bit.
    Same register sequence as SYSCFG_DL_VREF_init + SYSCFG_DL_DAC12_init,
    spelled out against VREF_*/DAC12_* device-header aliases.
    [laser_dac.c, laser_dac.h, laser_driver.c]
2026-06-03 Route hot-path GPIO/timer/IRQ through register-level modules
    laser_driver.c's runtime code (button read, STIM_MIRROR set/clear,
    TIMA0 duty update, TIMG0 + UART0 IRQ handlers) now calls the new
    register-level inlines instead of driverlib. Local set_laser_step and
    tick_timer_init helpers are gone — replaced by laser_timera_set_duty
    and laser_timerg_init/_start.
    SYSCFG_DL_init() still runs at boot as a redundant safety net
    (SysConfig and our hand-rolled modules both write the same registers
    to the same values). Removing it is the next step, but it needs a
    UART init port and a Makefile change to stop running the SysConfig
    generator — held for tomorrow.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
    [laser_driver.c]
2026-06-03 Drop SysConfig dependency: add laser_uart, retire ti_msp_dl_config
    laser_uart.c/h replicates SYSCFG_DL_UART_0_init at register level:
    reset+power, BUSCLK source /1, 8N1 no flow control, 16x oversampling,
    IBRD=208 FBRD=21 (9600 baud at 32 MHz), RX interrupt enabled. Inline
    helpers for IIDX/RX/TX.
    laser_pwm_control.c now uses board.h pin macros instead of the
    SysConfig-generated BRIDGE_LASER_* names, and its TIMA0 init function
    is gone (replaced by laser_timera_init). Header trimmed to just the
    two runtime pin-mux flips.
    laser_driver.c: dropped SYSCFG_DL_init(), the ti_msp_dl_config.h
    include, the duplicate DL_TimerG_startCounter, and laser_pwm_init.
    Boot path is now strictly the laser_*_i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
    [laser_driver.c, laser_pwm_control.c, laser_pwm_control.h, laser_uart.c, laser_uart.h]
2026-06-03 Add Makefile.gcc for arm-none-eabi-gcc Pi-native builds
    Mirrors the ticlang Makefile but targets stock arm-none-eabi-gcc using
    the SDK's gcc startup file and .lds linker script. Outputs .elf, .bin
    (BSL-friendly raw image), and .hex (OpenOCD/probe-friendly).
    Drop SDK_ROOT in via make var when vendoring the SDK to a different
    path on the Pi:
    make -f Makefile.gcc SDK_ROOT=~/mspm0_sdk all
    Untested on this box (arm-none-eabi-gcc not installed); flags are
    standard for Cortex-M0+ embedded. Validation happens on the Pi.
    CLAUDE.md rewritten to drop the stale SysConfig/CCS instructions and
    document the new module layout, both toolchains, and updated pin map.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
2026-06-03 Vendor MSPM0 SDK headers + startup + linker scripts into sdk/
    Drop the last external dependency in the build (besides the compiler
    itself). Headers, CMSIS Cortex-M0+ files, GCC + TI-CLANG startup
    sources, and both linker scripts now live in the repo under
    Firmware/laserHatFirmware/sdk/. Both Makefiles point at the vendored
    tree; no SDK_ROOT override needed.
    Total vendored: 87 files, ~9.5 MB. Source: TI MSPM0 SDK 2.10.00.04,
    unmodified. License terms in each file's header are preserved.
2026-06-03 Prune vendored SDK to minimal flat layout + hand-curated mcu.h
    Replace the sdk/ tree (87 files, 9.5 MB) with a flat in-project layout
    containing only what the firmware actually compiles against:
    mcu.h new self-contained device header (~150 lines).
    Defines IRQn_Type, peripheral base addresses + pointer
    macros, IOMUX PINCM indices, and the eight PINCM
    peripheral-function codes our pins use. Each section
    cites the TI source it was extracted from.
    cmsis/ 7 files - minimal CMSIS Cortex-M0+ core + the two
    compiler-intrinsic variants we use (armclang + gcc).
    hw/ 7 files - periphe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
    [board.h, laser_dac.c, laser_dac.h, laser_driver.c, laser_gpio.c, laser_gpio.h, laser_pwm_control.c, laser_sysctl.c]
2026-06-03 Make TI Makefile OS-portable; add Firmware README with Pi setup
    Makefile now detects Linux vs macOS via uname and sets a sensible
    default CC for each. Gated on \$(origin CC) so Make's implicit cc
    default doesn't shadow it. CC override on command line or env still
    wins. TI_TOOLCHAIN_VER overrideable too.
    README documents the three build flows (Linux/macOS/Pi), the Pi UART
    console setup (raspi-config, config.txt, cmdline.txt), the dialout
    group, a picocom + pyserial smoke test, and the Pi↔MCU wiring map.
2026-06-03 Make Makefile dispatch by uname so 'make' works on the Pi too
    Rename the TI ARM CLANG Makefile to Makefile.ticlang and put a tiny
    dispatcher at Makefile that forwards goals to the right sub-Makefile:
    ARM Linux (Pi, uname -m = aarch64/armv7l/armv6l) -> Makefile.gcc
    everything else -> Makefile.ticlang
    Explicit invocation still works for either: `make -f Makefile.gcc` or
    `make -f Makefile.ticlang`. All command-line overrides
    (CC=..., TI_TOOLCHAIN_VER=...) and targets (clean, all, ...) are
    forwarded.
    README and CLAUDE.md updated to describe the new file split.
2026-06-03 Add make flash / load / burn / reset for SWD via Pi GPIO + OpenOCD
    New openocd/pi-swd.cfg drives the SWD pins from the Pi via OpenOCD's
    linuxgpiod adapter:
    Pi GPIO 25 -> MSPM0 SWCLK
    Pi GPIO 24 -> MSPM0 SWDIO
    Pi GPIO 18 -> MSPM0 NRST
    Makefile.gcc gains four phony targets:
    flash, load, burn -> program the ELF, verify, reset, exit
    reset -> reset the MCU only
    Default gpiochip is 0 (Pi 4 layout); override with
    OPENOCD_GPIOCHIP=4 on the make command line for Pi 5 (RP1 chip is
    exposed as /dev/gpiochip4). OpenOCD binary, interface file, and
    target script paths are all overridable via the same make-var
    mechanism.
    README documents the prerequisite apt install of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
    [pi-swd.cfg]
2026-06-03 Drop OpenOCD verify from 'make flash'; add separate 'make verify'
    The CRC verify algorithm OpenOCD runs after a program command hangs
    on ti_mspm0.cfg in stock Bookworm OpenOCD - target halts and never
    returns control to the host, then the binary-compare fallback reads
    back garbage and reports a checksum mismatch. The write itself is
    reliable, so just drop verify from the program command.
    'make verify' is a separate target that does a clean binary compare
    via verify_image after a reset halt, for users who want belt-and-
    braces confirmation. Boot-blink LED on the HAT is the practical
    visual confirmation that flashing took.
2026-06-03 Move boot blink out of the state machine into a busy-wait loop in main
    The OVERALL_BOOT phase added an extra enum value, two timing
    constants, ~10 lines in get_next_state, and a special branch in
    set_output - all to drive an LED that doesn't need to share any
    state with the laser logic.
    Replace it with a plain busy-wait loop in main() before the timers
    start. The state machine starts directly in OVERALL_WAITING.
    delay_cycles is a small static helper using a volatile loop counter;
    precision is irrelevant for an 'I am alive' indicator.
    Net diff: -20 lines from laser_driver.c, with the state machine
    purely concerned with idle/pulse logic now.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
    [laser_driver.c]
2026-06-03 Add UART command protocol: intensity / ramp / hold / trigger / query
    Wire format on UART0 (115200 8N1, \n-terminated):
    i N set peak PWM duty (1..320)
    r N set ramp-up total ticks
    h N set hold ticks
    t trigger one pulse
    ? query state -> OK i=N r=N h=N b=BBBB phase=W|T tick=TTT
    All commands reply on one line. i/r/h/?: immediate OK. t: no
    immediate ACK; on actual state-machine transitions the firmware
    emits OK pulse start=TTT and later OK pulse end=TTT. Errors come
    back as ERR <reason>.
    PulseConfig is held in two file-static globals - g_config_live
    (mutated by UART) and g_config_active (snapshotted at the
    WAITING -> TRIGGERED edge). ticks-per-step is derived on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
    [board.h, laser_driver.c, laser_gpio.c, laser_gpio.h, laser_uart.c, laser_uart.h]
2026-06-03 Accept CR as well as LF as line terminator; add Python smoke test
    picocom sends CR (0x0D) on Enter, not LF (0x0A), so the firmware was
    accumulating bytes until the line buffer overflowed and never running
    the command. Treat both CR and LF as line terminators in drain_uart
    and silently skip empty lines (so CRLF doesn't double-fire and a
    blank Enter is a no-op).
    host_tools/smoke_test.py walks the protocol end-to-end via pyserial -
    ?, i/r/h sets, t with the two-line pulse ACK, and a restore-to-
    defaults round trip. Defaults to /dev/ttyS0; pass another path as
    argv[1] for /dev/ttyAMA0.
    [laser_driver.c]
2026-06-03 Pi-side eink MVP: show IP + hostname on the SSD1680Z
    One-shot Python script + systemd service + timer. No buttons, no
    firmware UART connection, no daemon - just confirms the eink panel
    is wired right and can render. Display shows 'LaserHAT' header,
    the primary IPv4 address, the hostname, and a thin red rule across
    the bottom so a stale frame is obvious.
    Builds on the user's existing adafruit_epd validation code; the
    dependency stack (adafruit-blinka + Pillow + circuitpython-epd)
    is real but well-tested and lets the script stay around 50 lines
    instead of 600 of register-level SPI work. Worth revisiting only
    if we want the MSPM0 to drive the panel in standalone mode (which
    requires a board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
2026-06-03 Pi-side eink GUI mockup: parameter editor + pulse trigger
    Adds the smallest useful GUI for the LaserHAT:
    - laser_hat.py is a thread-safe UART client class wrapping the line
    protocol (?, i N, r N, h N, t). Includes a small CLI for poking
    the MCU without the display (query / set / trigger / watch).
    - eink_gui.py is a long-running daemon: polls hat.get_state() at
    20 Hz, runs press-edge detection on the firmware-debounced button
    mask, dispatches to a tiny UI state machine, pushes config edits
    back over UART, and repaints the SSD1680Z when state changes.
    Button mapping matches the physical layout:
    B1 (top-left) trigger pulse — firmware fires on release,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
2026-06-04 Drop adafruit_epd; own SSD1680 driver with partial refresh
    eink_panel.py is a ~250-line self-contained SSD1680 / GDEY0213B74
    driver on spidev + gpiozero + Pillow. Exposes display(image,
    force_full=False) — partial refresh by default (~300 ms instead of
    ~3 s), with an automatic full refresh every 30th call to clear
    ghosting.
    eink_gui.py rewritten on PIL + EinkPanel. Replaces the artificial
    2-second REFRESH_MIN_GAP with a 300 ms settle window after the last
    button press, so rapid B4 presses coalesce to one refresh at the
    final value but a single press paints right away. TTF fonts via
    PIL (DejaVuSans, falls back to PIL default).
    eink_ip.py migrated to the same driver for consistency; the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
    [eink_gui.py]
2026-06-04 Use gpiozero InputDevice for BUSY; pin lgpio backend
    DigitalInputDevice sets up edge-change callbacks in its ctor, and on
    Bookworm + Pi 5 the rpi.gpio fallback path errors out with
    "Failed to add edge detection". We only poll the BUSY pin, so
    InputDevice (the parent class) is the right choice — no callbacks
    registered, no edge-detection machinery touched.
    Add lgpio to requirements.txt so gpiozero uses the proper backend
    on Bookworm instead of the rpi.gpio fallback that triggered the
    fall-through warning.
2026-06-04 Pi-side web GUI: Flask + single-page vanilla JS
    web_app.py wraps LaserHat in a tiny Flask app:
    GET / index page
    GET /api/state current MCU snapshot as JSON
    POST /api/set/<knob> { value: N } for knob in {i, r, h}
    POST /api/trigger fires a pulse
    GET /api/healthz liveness
    Single-page UI in templates/index.html — no frameworks, dark-mode
    aware via prefers-color-scheme. Per-knob step input + ± buttons,
    big TRIGGER PULSE action, live indicator for the four MCU buttons
    (debounced state, updates with the 500 ms poll), and a phase pill
    that flips to TRIG/red while a pulse is running. Trigger button
    disables itself during TRIGGERED so we don't get ERR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
    [web_app.py]
2026-06-04 Move pulse state machine into TIMG0 ISR; isolate from UART/buttons
    Pulse timing now lives entirely in TIMG0_IRQHandler (100 kHz):
    the ISR advances the state machine, drives PWM + STIM_MIRROR
    outputs, and sets pulse-event flags for the main loop to ACK over
    UART. Nothing else - UART parsing, button debounce, future GPIO
    edge ISRs - can shift a single PWM-duty write.
    Triggers are mediated via three volatile flags consumed by the ISR:
    g_uart_trigger_pending (parser, 't' command)
    g_button_trigger_pending (main loop, BUTTON1 release)
    g_hw_trigger_pending (BNC + Pi-GPIO edge ISRs, wired next)
    Pulse-event ACKs (OK pulse start/end) stay on the main loop side -
    the ISR sets g_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
2026-06-04 Add TIMG6 housekeeping timer @ 1 kHz; gate main-loop work on it
    mcu.h gains TIMG6_BASE / TIMG6 / TIMG6_INT_IRQn. (The user asked
    for "TIMG13" but the device only has TIMG0/6/7/8/12 — TIMG6 was
    unused so we take it.)
    laser_timerg.c factors out a shared init_periodic() helper and
    exposes init_tick/start_tick (TIMG0, 100 kHz) and
    init_housekeeping/start_housekeeping (TIMG6, 1 kHz). Inline
    peripheral-ack helpers renamed accordingly.
    Main loop now gates drain_uart + poll_buttons + emit_pulse_events
    on g_housekeeping_due, set by TIMG6_IRQHandler at 1 kHz. TIMG0
    ticks (100 kHz, pulse state machine) still wake main from WFI but
    main sees no flag and re-WFIs immediately - the housekeeping work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
2026-06-04 Add BNC trigger edge ISR on PA14
    PA14 was already wired to STIM_TRIGGER per the schematic — now the
    firmware actually consumes it.
    board.h: BOARD_BNC_TRIGGER_PIN / BOARD_BNC_TRIGGER_PINCM.
    mcu.h: GPIOA_INT_IRQn = 1 (shared GROUP1 vector); fix the PA14
    annotation that still said 'unused'.
    laser_gpio.c: configure PA14 as input with INENA, set POLARITY15_0
    bits 28-29 to RISE (0b01), clear any latched MIS, then
    unmask PA14 in GPIOA->CPU_INT.IMASK. Pin removed from the
    unused-pin list + UNUSED_PIN_MASK.
    laser_driver.c: GROUP1_IRQHandler reads GPIOA->CPU_INT.MIS; if
    the BNC bit is set, clears it and sets g_hw_trigger_pending
    for the TIMG0 state-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
    [board.h, laser_driver.c, laser_gpio.c, mcu.h]
2026-06-04 Reclaim PA19 (SWDIO) as Pi-GPIO trigger input after boot
    After the boot blink finishes, main() calls laser_gpio_arm_pi_trigger()
    which switches PA19's IOMUX from SWDIO (function 2, boot default) to
    plain GPIO input (function 1), with INENA on and rising-edge
    detection. The PA19 bit is ORed into GPIOA's CPU_INT.IMASK alongside
    the existing PA14 (BNC) entry, so both triggers share the GROUP1
    vector.
    GROUP1_IRQHandler now clears whichever pin(s) fired and sets the
    single g_hw_trigger_pending flag - the state machine doesn't care
    which hardware source produced the edge.
    NRST always restores PA19's default SWDIO mux, so 'make flash' from
    the Pi continues to work: power-cycle MCU, assert NRST,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
    [board.h, laser_driver.c, laser_gpio.c, laser_gpio.h, mcu.h]
2026-06-04 Pi-GPIO trigger path: pi_trigger.py + web UI button
    The firmware's PA19 edge ISR is now exercisable from the Pi. Two
    pieces:
    Pi/pi_trigger.py PiTrigger class wrapping gpiozero.DigitalOutputDevice
    on GPIO 24 (= MSPM0 PA19). 500 us high pulse - comfortably
    longer than the firmware's 10 us TIMG0 tick and any
    Python time.sleep jitter. CLI:
    python3 pi_trigger.py fire
    Pi/web_app.py Two trigger routes side-by-side:
    POST /api/trigger UART path (existing)
    POST /api/trigger_gpio GPIO path (new)
    Browser shows them as TRIGGER (UART)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
    [pi_trigger.py, web_app.py]
2026-06-04 Stop spurious pulse when Pi releases GPIO 24 (web app exit)
    Two-part fix.
    MCU: PA19 now configures with internal pull-down (IOMUX_PINCM_PIPD_ENABLE)
    in addition to the existing INENA + GPIO function bits. When the Pi
    releases GPIO 24 (e.g. when web_app.py exits and gpiozero closes its
    DigitalOutputDevice), the line idles low instead of floating. Without
    the pull-down the input transition was looking like a rising edge to
    the GPIO ISR and firing a phantom pulse.
    Pi: PiTrigger.close() now drives the pin low before calling close()
    on the gpiozero device. Belt-and-braces on top of the MCU pull-down.
    [laser_gpio.c, pi_trigger.py]
2026-06-04 OpenOCD: connect under reset so 'make flash' survives PA19 reclaim
    After the firmware reclaims PA19 (SWDIO) as a plain GPIO input
    shortly after boot, subsequent SWD connects fail with
    "Error connecting DP: cannot read IDR" — PA19 is no longer the
    SWDIO line OpenOCD is trying to wiggle.
    Fix: have OpenOCD assert NRST throughout the initial probe. The
    MCU stays in reset (PA19 reverts to default SWDIO), DP IDR reads
    succeed, programming proceeds, NRST releases on exit.
    pi-swd.cfg gains:
    reset_config srst_only srst_nogate connect_assert_srst
    - srst_only: use the NRST line, not the cortex_m driver's
    SYSRESETREQ path (which needs SWD already working).
    - srst_nogate: don't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
    [pi-swd.cfg]
2026-06-04 PA19 trigger is now opt-in; auto power-cycle before SWD flash
    The previous firmware unconditionally reclaimed PA19 (SWDIO) as a GPIO
    input ~4 seconds after boot, after which SWD could no longer probe the
    chip and 'make flash' failed. connect_assert_srst nominally worked
    around it but held DEBUGSS in reset so MEM-AP examination failed too.
    Restructure into something that just works every time:
    Firmware:
    - main() no longer calls laser_gpio_arm_pi_trigger().
    - New UART command `g\n` (idempotent) arms PA19. Status response
    gains a `g=0|1` field reflecting the armed state.
    - No disarm — to put PA19 back to SWDIO, reset the MCU (which 'make
    flash' now does as a prerequisite, so no manual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
    [pi-swd.cfg]
2026-06-04 power_cycle.py: use Pi OS pinctrl, drop gpiozero/lgpio dependency
    The previous gpiozero-based implementation showed a fallback warning
    ("Falling back from lgpio: No module named 'lgpio'") and the resulting
    RPi.GPIO path doesn't reliably drive pins on Pi 5 / Bookworm. Result:
    the MCU wasn't actually getting power-cycled, the laser blipped during
    the cycle (PA19 floating on the old firmware picking up noise), and the
    SWD probe afterward still saw the old firmware's GPIO state.
    Switch to subprocess + pinctrl. pinctrl ships pre-installed on every
    recent Pi OS image, works the same on Pi 4 / Pi 5, doesn't care about
    which Python GPIO library is around. Same behaviour - drive 23 LOW
    for N ms,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
    [power_cycle.py]
2026-06-04 power_cycle: park UART TX / NRST / SWD pins so MSP can't phantom-power
    User confirmed via observation:
    - MCU power LED on the HAT does go off when GPIO 23 is driven LOW
    (so power gating works)
    - But STIM_MIRROR doesn't blink afterwards (MCU never re-boots)
    Classic phantom powering through MSP's IO ESD diodes: Pi GPIO 14
    (UART TX) idles HIGH at the kernel UART driver, that HIGH signal
    hits PA11's input clamp, current flows back through the upper diode
    into VDD, and the MSP runs partially even with its main rail cut.
    Fix: park every Pi GPIO that connects to an MSP IO pin before cutting
    the rail, restore them after.
    Before cycle:
    GPIO 14 (UART TX -> PA11 RX) -> INPUT (high-Z, no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
    [power_cycle.py]
2026-06-04 make flash: explicit init/halt/write_image/reset, bypass program's auto reset
    OpenOCD's `program file reset exit` does an implicit init-time reset
    that triggers a target-side halt inside ti_mspm0.cfg. On this chip
    the halt-on-reset's vector catch isn't latching reliably, so the
    halt times out and `init` fails with:
    Info : [mspm0x.cpu] external reset detected
    Error: timed out while waiting for target halted
    ** Unable to reset target **
    We've already power-cycled in the prerequisite, so the MCU is in a
    known-good state mid-boot-blink with PA19 as SWDIO. All `program`
    needed was to halt + write + reset, and the halt of a freely-running
    CPU works fine — it's the halt-on-reset c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
2026-06-04 power_cycle: save and restore the original pinctrl mode of parked pins
    After a successful flash the kernel UART driver wasn't reclaiming
    GPIO 14 — we had set it to input ('ip') for the parking phase, and
    once make flash exits the line is still in input mode, so /dev/ttyS0
    opens succeed but no bytes ever come back. Web app reports "MCU no
    response" and the laser stops responding to triggers.
    Fix: snapshot the pinctrl mode of every parked pin before changing
    it, then restore each one at the end of the cycle. For GPIO 14 that
    means going back to the alt mode the mini-UART (or PL011) was using
    (a5 / a0 depending on dtoverlay config), so the kernel driver
    continues to own the line transparen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
    [power_cycle.py]
2026-06-04 power_cycle: fall back to a UART alt when save captures 'ip'
    The previous fix assumed power_cycle ran with GPIO 14 in its proper
    kernel-UART alt mode and faithfully restored whatever it saved. But
    after a previous run had left the pin parked as 'ip', the save
    captures 'ip' too and faithfully restores to the same broken state -
    the chicken-and-egg failure mode.
    When the saved mode for GPIO 14 is 'ip', override the save with the
    fallback alt (a5 by default = mini-UART = /dev/ttyS0). Users running
    on PL011 / /dev/ttyAMA0 can edit UART_TX_FALLBACK_ALT to 'a0' in the
    script.
    Also prints a one-line message when the fallback kicks in so the
    recovery is visible.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
    [power_cycle.py]
2026-06-04 README: document the flash dance, g command, recovery procedure
    Expand the 'Flashing the MCU over SWD from the Pi' section with three
    sub-pieces:
    1. 'What make flash actually does' walks through the three steps the
    rule does in order: power_cycle (with the phantom-power story —
    why Pi GPIO 14/24/25 need to be parked, why we save/restore their
    modes), SWD probe during the boot-blink window with PA19 still as
    SWDIO, and the explicit init/halt/write_image/reset sequence
    that bypasses program-reset's vector-catch halt failure.
    2. 'Recovery if make flash leaves something stuck' covers the manual
    pinctrl steps for the case where a previous run left GPIO 14
    parked as input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
2026-06-04 Fix dropped-ACK race: per-event via_uart in PulseEvent records (B1/A1)
    Replace the shared g_pulse_via_uart flag (read by main across a whole
    pulse) plus the separate g_pulse_*_evt / g_pulse_*_evt_tick flags with
    two PulseEvent records {tick, via_uart, pending}. Each event now carries
    its own via_uart bit, stamped by the ISR at the instant the event is
    generated.
    Previously, when a UART pulse finished (overall -> WAITING) and a BNC or
    Pi-GPIO trigger started the next pulse on a following tick *before* main
    drained the end event, the new pulse's start would overwrite the shared
    g_pulse_via_uart with false, suppressing the prior UART pulse's "OK pulse
    end" ACK and timing out the waiting client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
    [laser_driver.c]
2026-06-04 trigger(): treat empty reply as failure, not success (B2)
    readline() returning "" means the timeout elapsed with no response — a
    powered-off or wedged MCU. The old `not reply.startswith("ERR")` reported
    that empty string as success, so the web "TRIGGER (UART)" button looked
    like it worked against a dead MCU. Require a non-empty reply, matching
    get_state()'s None-on-timeout handling.
    [laser_hat.py]
2026-06-04 Add internal pull-down on the PA14 BNC trigger input (B4)
    A released or unterminated BNC line was left floating, so noise could
    look like a rising edge and fire the laser. Enable IOMUX_PINCM_PIPD so
    the line idles LOW, active-high to match the Pi-trigger input (PA19).
    [laser_gpio.c]
2026-06-04 Remove dead laser_gpio_read_button1() (S2)
    poll_buttons() uses laser_gpio_read_buttons_raw() exclusively; the
    single-button reader had no callers.
2026-06-04 laser_driver: drop IRQ guards, guard parse_decimal overflow, dedupe output writes
    Three independent fixes in laser_driver.c:
    S1 — Remove __disable_irq()/__enable_irq() around the single-field
    g_config_live writes. Each is one aligned store (atomic on Cortex-M0+)
    and the ISR's field-by-field latch is the consistency point, so the
    bracketing protected nothing. Updated the architecture and
    latch_config_from_live comments to state the actual invariant.
    B3 — Add an overflow guard to parse_decimal: reject before v*10+digit
    can wrap past UINT32_MAX. Previously e.g. "i 4294967297" wrapped to 1,
    passed the 1..320 range check, and silently set a wrong setpoint.
    S4 — Add a RAM-shadow change-gu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
    [laser_driver.c]
2026-06-04 Comment fixes: eink inversion, UART FEN rationale, PA19 pointers (C1/C2/A2)
    C1 — eink_panel._image_to_buffer: the comment claimed an inversion the
    code never performs. Rewrite to explain why none is needed (PIL "1"
    MSB-first packing and SSD1680 BW RAM agree, 1 = white).
    C2 — laser_uart.c: drop the stale "echo placeholder" reference; keep the
    real reason FEN is cleared (one RX interrupt per byte for the parser).
    A2 (part 1) — add one-line pointers from the PA19 SWDIO<->GPIO arming
    code sites (g_pi_trigger_armed, the 'g' handler, laser_gpio_arm_pi_trigger)
    to the canonical prose in board.h / README.md.
    [laser_driver.c, laser_gpio.c, laser_uart.c]
2026-06-04 Rewrite Firmware CLAUDE.md to match current architecture (C5)
    The ISR/state-machine section described a prior design. Fix the four
    inaccuracies the audit flagged:
    - "no state-machine logic inside ISRs" — the whole machine runs in
    TIMG0_IRQHandler; document that this is deliberate and why.
    - nonexistent get_next_state()/set_output() — replace with the real
    state_machine_tick()/set_output_from_state() and note the RAM-shadow
    idempotency.
    - wrong ack helper name laser_timerg_ack() -> laser_timerg_tick_ack().
    - module table: UART is 115200 8N1 with an RX ring + line parser, not a
    "9600 baud placeholder echo".
2026-06-04 Rename firmware sources by function, drop the laser_ prefix (R1)
    History-preserving git mv of every application module to a
    function-named file, plus the matching include/guard/Makefile/doc
    updates:
    laser_driver.c -> main.c
    laser_timera.{c,h} -> pwm_timer.{c,h}
    laser_timerg.{c,h} -> tick_timers.{c,h}
    laser_pwm_control.* -> output_mux.{c,h}
    laser_dac.{c,h} -> dac.{c,h}
    laser_uart.{c,h} -> uart.{c,h}
    laser_gpio.{c,h} -> gpio.{c,h}
    laser_sysctl.{c,h} -> sysctl.{c,h}
    - Updated all #include directives and rewrote the header guards
    (LASER_TIMERA_H -> PWM_TIMER_H, etc.).
    - Updated the OBJS list and the build artifact names in Makefile.gcc and
    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
2026-06-04 Add binary wire protocol + codec (COBS + CRC16), both sides
    Define the LaserHat binary framed protocol as a single source of truth:
    Pi/protocol.py and the firmware mirror protocol.h, plus the C codec
    (crc16, cobs, framing) and the Python codec.
    Frames are COBS-encoded (0x00-delimited, self-resyncing) over a
    CRC16-CCITT body; typed messages (CMD_*, RSP_*, EVT_*) replace the old
    ASCII line protocol. host_tools/proto_crosscheck.py builds the C codec
    natively and confirms it is byte-identical to the Python encoder/decoder;
    Pi/tests/test_protocol.py covers COBS/CRC edge cases, framing, resync,
    and corruption handling.
    [framing.c, framing.h, protocol.h, protocol.py, test_protocol.py]
2026-06-04 Replace firmware text parser with binary frame dispatch
    Feed RX bytes to the COBS/CRC frame decoder and dispatch typed command
    frames (CMD_SET_*/TRIGGER/ARM/QUERY), replying with RSP_ACK / RSP_STATUS.
    Drop the ASCII line parser, parse_decimal, and the emit_* text helpers;
    uart.c swaps tx_str/tx_u32 for tx_buf.
    Emit pulse events (EVT_PULSE_START/_END) unconditionally for every
    trigger source and remove the via_uart gating machinery: with the host
    broker routing all typed frames by type, the one-reply-per-command
    desync the gating guarded against no longer exists. Add EVT_BUTTON so
    the host learns debounced button edges without polling.
    Wire the new crc16/cobs/framing objects into both Makef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
    [main.c, uart.c, uart.h]
2026-06-04 Add UART broker daemon, binary transport, and client
    broker.py is the single owner of /dev/ttyS0: it speaks the binary
    protocol to the MCU, mirrors MCU state, and serves clients over a
    dependency-light newline-JSON Unix socket (pub/sub — clients publish
    commands, broker broadcasts state + button/pulse events). It also owns
    the PiTrigger pin and the one-time PA19 arming, so the GPIO trigger no
    longer re-arms per request (audit S3).
    laser_hat.py becomes the binary UART transport (LaserUART) used only by
    the broker, keeping the shared State dataclass. hat_client.py is the thin
    GUI-facing client (cached State + update callback). fake_mcu.py is a PTY
    that speaks the protocol so the broker and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
    [broker.py, fake_mcu.py, hat_client.py, laser_hat.py, test_integration.py]
2026-06-04 Migrate eink and web GUIs to the broker client
    Both GUIs now use hat_client.HatClient instead of opening the serial
    port, so they run at the same time. The eink GUI is event-driven: it
    reacts to broadcast state and EVT_BUTTON edges (the B2/B3/B4 UI policy
    moves here) rather than polling the MCU at 20 Hz. The web app reads the
    broker's cached state and routes triggers/sets/arm through the client;
    the GPIO trigger no longer re-arms per request.
    tests/test_web.py drives the migrated Flask routes against fake_mcu +
    broker via the test client.
    [eink_gui.py, test_web.py, web_app.py]
2026-06-04 Add broker service, drop the single-UART-owner constraint, docs
    Add laserhat-broker.service (owns /dev/ttyS0, RuntimeDirectory=laserhat
    for the socket). Remove Conflicts=eink-gui.service from the web unit and
    point both GUI units at the broker (Requires=laserhat-broker.service,
    LASERHAT_SOCK) so they no longer fight over the port and can run
    together. Update Pi/README.md for the broker topology and refresh the
    deploy/testing instructions; ignore Python bytecode/pytest cache.
2026-06-05 Share GUI parameter step sizes between eink and web
    Add Pi/params.py as the single source of truth for each knob's step
    size and range. The eink GUI and the web GUI both read it, so the
    increment sizes (i:8, r:200, h:500) no longer drift between surfaces;
    only the eink-specific value formatting stays local. The web template's
    ramp/hold step inputs also gain the correct max from the shared spec.
    [eink_gui.py, params.py, web_app.py]
2026-06-05 Remove ramp-down / trailing-low pulse phase
    Pulses ramp up, hold at full, then switch off — they are not trapezoidal.
    Drop the LASER_RAMP_DOWN and LASER_HOLD_LOW states: HOLD_HIGH now ends the
    pulse directly (off + return to WAITING + emit pulse-end). Update the
    state-machine comments and the `h` command doc (it sets the hold-high
    duration only, no trailing-low tail).
2026-06-05 Revert set_output_from_state to unconditional idempotent writes
    Drop the RAM-shadow change-guard (audit S4). The operations it skipped
    are all plain register stores (laser_pins_to_*, set_duty) — there were
    no peripheral reads to avoid, and on Cortex-M0+ a store is cheap, so the
    guard saved little while adding a per-tick compare and complexity.
    Re-asserting the output state every 10 us is simpler and self-healing:
    if the IOMUX/GPIO is ever perturbed, the next tick restores the safe
    laser-output configuration. Update CLAUDE.md to match.
    [main.c]
2026-06-05 Catch firmware README + smoke_test up to the binary protocol
    The "Quick UART smoke test" section still documented the old ASCII line
    protocol (i N / r N / t / OK pulse..., picocom). Rewrite it for the
    binary framed protocol (CMD_*/RSP_*/EVT_*), pointing at protocol.h /
    Pi/protocol.py as the message map, and note the broker owns the port.
    Rewrite host_tools/smoke_test.py to speak binary, reusing the Pi-side
    codec and LaserUART transport so there's one wire-protocol implementation.
    Its buffered reader keeps frames that share a read() (e.g. RSP_ACK +
    EVT_PULSE_START) so the trigger check is reliable. Verified end-to-end
    against Pi/fake_mcu.py.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
2026-06-06 Redesign wire protocol: magic framing, CONFIG, status-as-ack, no CRC
    Replace the COBS+CRC16 framing with magic-word framing: SYNC(DE AD) |
    TYPE | payload, length implied by TYPE, payload verbatim, no length byte,
    no stuffing, no CRC. SYNC bytes are both >= 0x99 so they can only collide
    with the low 16 bits of ramp/hold; avoid_magic() nudges the ~150 such
    values so a CONFIG payload never contains SYNC and the MCU resyncs exactly.
    Collapse Pi->MCU to CMD_CONFIG{i,r,h} + CMD_TRIGGER + CMD_QUERY, and make
    RSP_STATUS the universal answer to every command (status-as-ack): the
    broker confirms end-to-end that the MCU holds what it sent, which replaces
    the CRC. Decoded STATUS is range-checked to rej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
    [protocol.h, protocol.py, test_protocol.py]
2026-06-06 Firmware: magic-word framing, CONFIG handler, PA19 claimed at boot
    Delete crc16/cobs; rewrite framing.c/h as a magic-word scanner/encoder.
    Rewrite the main.c command path: CMD_CONFIG applies i/r/h atomically (in
    range or not at all), CMD_TRIGGER arms a pulse, and every command replies
    RSP_STATUS (status-as-ack). Drop emit_ack and the per-knob handlers.
    Claim PA19 as the Pi-GPIO trigger at the end of boot instead of on a (now
    removed) CMD_ARM, so the ~4 s boot blink remains the SWD flash window.
    Update both Makefiles and CLAUDE.md. Clean build under TI ARM CLANG.
2026-06-06 Pi broker/client/transport for the magic-framed protocol
    Broker uses RSP_STATUS as the ack: it sends a command, waits for the
    STATUS echo, and for config verifies the MCU now holds the values it
    sent. Per-knob set_* are assembled into one atomic CMD_CONFIG from the
    broker's authoritative cache (with avoid_magic so the payload can't
    contain SYNC). Drop the arm path; trigger_gpio just drives the pin (PA19
    is a trigger from boot). LaserUART/State drop the armed field; fake_mcu
    speaks the new protocol. Integration test passes against fake_mcu.
    [broker.py, fake_mcu.py, hat_client.py, laser_hat.py, test_integration.py]
2026-06-06 Update cross-check, smoke test, and protocol docs for magic framing
    Cross-check and smoke_test now exercise the magic-framed protocol
    (CONFIG/TRIGGER/QUERY + STATUS-as-ack), and the smoke reader keeps
    out-of-order frames so the trigger's pulse events aren't lost. Firmware
    README documents the new frame format, status-as-ack, no-CRC rationale,
    the PA19-from-boot behaviour, and the flash-with-laser-unplugged rule;
    Pi README updated to match.
2026-06-06 Add hardware bring-up & test checklist
    Top-down on-board test plan for the magic-framed protocol + broker stack:
    gcc build, flash, raw-link smoke test, pulse shape, broker + both GUIs
    together, all three trigger paths, resync robustness, reflash, and finally
    laser-connected. Steps 1-8 run with the laser unplugged (STIM_MIRROR LED
    stands in).
2026-06-06 Flatten Firmware/: code lives directly in Firmware/, drop Examples
    Move the firmware project up out of Firmware/laserHatFirmware/ so the
    sources live directly in Firmware/ (git mv preserves history). Delete
    Firmware/Examples/ and stale leftovers (laserHatFirmware.old, the unused
    laser_driver.syscfg — the firmware is hand-written, no SysConfig). Merge
    the two .gitignores.
    The CCS workspace file stays at Firmware/msp.theia-workspace with
    path "" — it now opens Firmware/ directly as the project (which carries
    .project/.ccsproject/.cproject). The CCS project name is left as
    "laserHatFirmware" (independent of the folder).
    Fix the relative paths that moved up a level: Makefile.gcc's power_cy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
    [pi-swd.cfg]
2026-06-06 Serialize via packed structs instead of put_/get_ helpers
    Replace the hand-written put_u16/put_u32/get_u16/get_u32 byte packing with
    packed payload structs (ConfigPayload, StatusPayload) in protocol.h.
    emit_status fills a struct and ships its bytes; apply_config casts the
    received buffer to a struct. Because both ends are little-endian and the
    structs are packed, the wire bytes are identical with no manual packing —
    and reading through a packed struct is safe on Cortex-M0+ (the compiler
    emits byte-wise access for misaligned members, which is exactly what the
    old get_ helpers did by hand).
    _Static_asserts lock the struct sizes to the protocol lengths, and the
    cross-check now compares the p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
    [main.c, protocol.h]
2026-06-06 Pi: rewrite README, remove redundant eink_ip one-shot
    Rewrite Pi/README.md to concisely describe the architecture and the three
    services (broker + eink/web GUIs), with a files table and a services table.
    Fix stale bits: the laser_hat CLI is `config <i> <r> <h>` (not `set`), drop
    the old `t`/`ERR busy` reference, and point at params.py for step sizes.
    Add the post-flash restart command
    (`systemctl restart laserhat-broker eink-gui laserhat-web`), which wasn't
    documented anywhere.
    Remove eink_ip.py + eink-ip.service + eink-ip.timer: the eink GUI already
    renders IP + hostname, so the standalone one-shot is redundant (and the two
    can't both drive the panel). Drop the stale eink-ip reference from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
2026-06-06 Pi: rewrite README (architecture + services) and fix eink-gui comment
    Concise rewrite of Pi/README.md (319 -> 131 lines): architecture diagram,
    files table, services table, install, operating. Fixes stale bits — the
    laser_hat CLI is `config <i> <r> <h>` (not `set`), drop the old `t`/`ERR
    busy` text, point step sizes at params.py — and documents the post-flash
    restart command. Drop the stale eink-ip reference from eink-gui.service.
    (Companion to the previous commit, which removed eink_ip + its units.)
2026-06-09 Pi: replace eink panel with Adafruit 128x32 OLED bonnet (SSD1305)
    The eink panel had issues; swap it for the Adafruit 4567 2.23" 128x32
    OLED bonnet (SSD1305 over I2C, reset on GPIO 4). The broker/button
    architecture is unchanged — the bonnet has no onboard buttons, so
    LaserHAT's four buttons still arrive from the MCU over the broker.
    - oled_panel.py: thin wrapper over adafruit_ssd1305 (framebuf driver),
    exposing the same size / new_canvas / display interface EinkPanel had
    so the GUI stays a near-drop-in. force_full is accepted and ignored
    (OLED repaints fully every frame).
    - oled_gui.py: ported from eink_gui.py; same broker-client state machine,
    layout recompacted for 128x32 (head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
    [broker.py, hat_client.py, oled_gui.py, params.py, web_app.py]
2026-06-09 Pi/oled_gui: add LaserHAT branding, move phase chip to bottom-right
    Header left slot now shows "LaserHAT" branding (with IP still
    right-aligned); the WAIT/TRIG phase chip moves to the bottom-right
    corner, painted over the tail of the last param row. Only the last
    row's "(…ms)" convenience text is ever covered, and only for large
    hold values — the raw tick count stays visible.
2026-06-16 Add EStim mode: paired monophasic pulses on STIM_MIRROR (PA13)
    New runtime-switchable mode (LASER / ESTIM) accessible via UART,
    broker socket, and web UI. In ESTIM mode the constant-current DAC
    is disabled and laser outputs are forced safe; a triggered pulse
    generates two monophasic pulses on PA13 with configurable per-pulse
    duration and interpulse interval (10–10000 µs, 100 kHz tick resolution).
    - protocol.h: CMD_SET_MODE (0x04), CMD_ESTIM_CONFIG (0x05), MODE_LASER/
    MODE_ESTIM constants, ESTIM_DUR/IPI limits; StatusPayload grows to 25
    bytes (mode u8, estim_dur_ticks u32, estim_ipi_ticks u32 appended)
    - framing.c: register new command payload lengths in cmd_payload_len()
    -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
    [broker.py, dac.c, dac.h, framing.c, hat_client.py, laser_hat.py, main.c, params.py]
2026-06-16 oled_gui: add EStim mode awareness — mode indicator + mode-toggle row
    - Header now shows [L] or [E] tag next to "LaserHAT" so the active mode
    is visible at a glance
    - B2 cycle extended with a [mode:LASER/ESTIM] sentinel row at the end;
    B4 on it switches to ESTIM, B3 switches to LASER
    - In ESTIM mode the selectable rows are dur/IPI/[mode] instead of i/r/h/[mode];
    B3/B4 adjust pulse duration and interpulse interval in 10-tick (100 µs) steps
    - 3-row window scrolls to keep the selected item always visible
    - Repaint key includes mode, estim_dur_ticks, estim_ipi_ticks so the
    display updates immediately when those values change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
2026-09-25 Add C broker (laserhat-brokerd) with low-latency UDP trigger listener
    laserhat-brokerd replaces broker.py with the same UART protocol and
    JSON socket (GUIs unchanged), and adds a network trigger path: a
    remote experiment machine sends a UDP datagram and a dedicated
    (optionally SCHED_FIFO, CPU-pinned) thread raises GPIO 24 -> MCU PA19
    via a direct /dev/gpiomem store, then ACKs with kernel rx and edge
    timestamps. At-most-once delivery; sender-driven retries reuse the seq
    and are answered "duplicate" instead of firing twice.
    - Pi/brokerd/: C daemon, protocol spec (udp_trigger.h), Pi 4 tuning notes
    - Pi/udp_trigger.py: sender library + latency CLI
    - tests: integration + web run against both bro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
    [brokerd.h, gpio.c, ipc.c, json.c, main.c, mcu.c, test_brokerd.py, test_integration.py]
2026-09-25 Package laserhat-brokerd and make it the broker service
    - build-deb.sh: cross-compile brokerd statically to /usr/bin
    - CI: native -Werror build of brokerd before the Pi test suite
    - laserhat-broker.service: run /usr/bin/laserhat-brokerd with UDP
    triggers bound to the static wired address (192.168.17.10:17017),
    trigger thread SCHED_FIFO 80 on CPU 3 (LimitRTPRIO/LimitMEMLOCK);
    broker.py stays as a commented fallback
    - brokerd: parse numeric IPV4:PORT instead of getaddrinfo (NSS lookups
    break in static binaries); IP_FREEBIND so the UDP bind succeeds while
    eth0 is down, instead of crash-looping the broker and its GUIs
    - docs: README, brokerd/README, PROVISIONING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
    [brokerd.h, ipc.c, main.c, trigger.c]
2026-09-27 Ship MCU firmware in the package with a manual laserhat-flash command
    Boards arrive with a blank MCU, and the image had no way to program
    one without installing a toolchain and flashing by hand.
    - build-deb.sh: build the firmware (Makefile.gcc, out of tree) from
    the same commit as the broker and install it to
    /usr/lib/laserhat/firmware/ with pi-swd.cfg and a VERSION file;
    Depends: openocd
    - laserhat-flash (sudo): stop broker + GUIs (GPIO 24 is also SWDIO),
    power-cycle into the boot-blink SWD window, OpenOCD write, restart
    whatever was running. Manual only: nothing flashes at boot.
    - CI: install gcc-arm-none-eabi for build-deb; golden-image build
    fails if the OS release's openocd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
2026-09-27 Fix OLED GUI not returning after flashing a blank board
    On a blank MCU oled_gui.py exited after 5 s without a state and
    crash-looped under Restart=on-failure. laserhat-flash only restarted
    units that were "active" when it ran, so a GUI caught between restarts
    ("activating") was stopped along with the broker and never came back,
    leaving the OLED on oledd's boot screen.
    - oled_gui.py: wait for the MCU indefinitely (warn once) instead of
    exiting
    - laserhat-flash: stop all broker/GUI units and restart every one that
    is enabled or was active
    [oled_gui.py]
2026-09-27 LaserHAT README: fix stale pin assignments
    The Pi GPIO usage table, MCU pin table, power-switch text and net list
    predated the schematic audit in gpio_design.md and the firmware's
    board.h: MCU power is GPIO23 (not 17), the Pi trigger is GPIO24 -> PA19
    (not GPIO26 -> PB21, which doesn't exist on the VQFN-32 part), PWM_LASER
    is PA21 (not PA8), the DAC is PA15, SWDIO/SWCLK are PA19/PA20, and the
    MCU is the MSPM0G3507SRHBR. Tables now list what the firmware and Pi
    software use and point to gpio_design.md for the full maps.
